BurtKim-ust/ASIC-MCU-for-the-Smart-Home-Sensors/works/layout/result/layout_no_sram.png

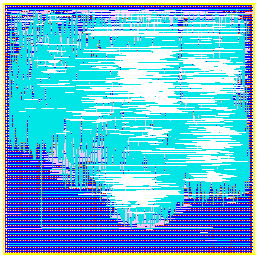
works/layout/result/layout_no_sram.png
